NewieVentures/Obelisk/sch/FP1/FP1.kicad_pcb

## KiCad design sch/FP1/FP1.kicad_pcb (2018-10-18)

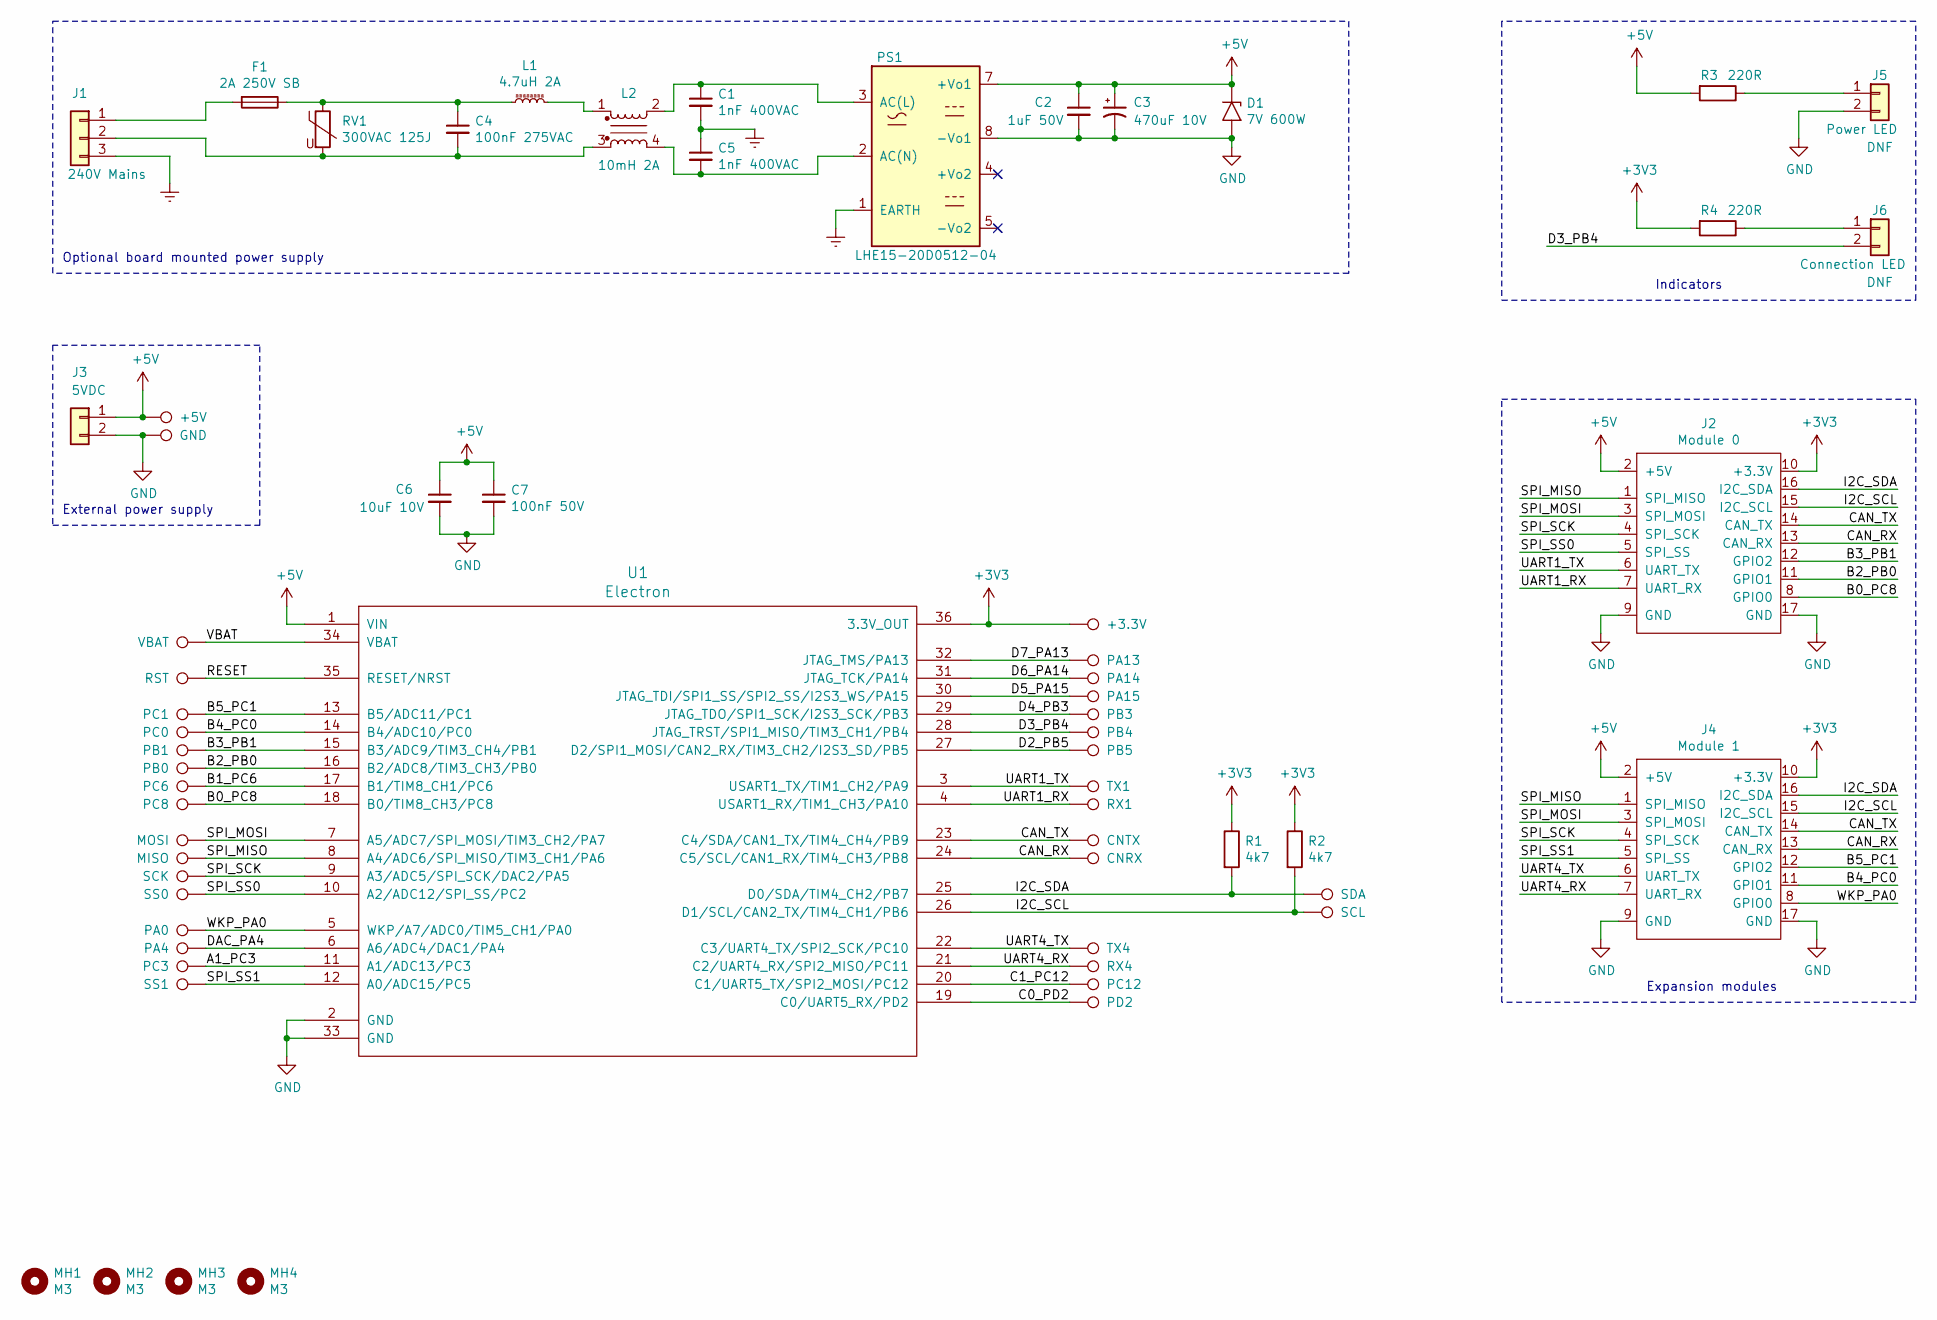
[picture p3: schematic FP1.sch, Faraday FP1]

Parts:
C1, C5: 1nF 400VAC; C_0805_2012Metric; Part Number CGA4C4C0G2W102J060AA
C2: 1uF 50V; C_0805_2012Metric; Part Number CL21B105KBFNNNG
C3: 470uF 10V; CP_Radial_D6.3mm_P2.50mm; Part Number ESH477M010AE3AA
C4: 100nF 275VAC; C_1210_3225Metric; Part Number C1210C104KBRAC7800
C6: 10uF 10V; C_0805_2012Metric; Part Number CL21A106KPCLQNC
C7: 100nF 50V; C_0805_2012Metric; Part Number GCM21BR71H104KA37K
D1: 7V 600W; D_SMB; Part Number SMBJ7.0A
F1: 2A 250V SB; Fuse_SMD_10W_3H; Part Number 3403.0169.11
J1: 240V Mains; JST_VH_B3P-VH-B_1x03_P3.96mm_Vertical; Part Number B3P-VH(LF)(SN)
J2: Module 0; Faraday_module; Part Number PPPC091LFBN-RC
J3: 5VDC; JST_VH_B2P-VH_1x02_P3.96mm_Vertical; Part Number B2P-VH(LF)(SN)
J4: Module 1; Faraday_module; Part Number PPPC091LFBN-RC
J5: Power LED; JST_VH_B2P-VH_1x02_P3.96mm_Vertical; Part Number B2P-VH(LF)(SN)
J6: Connection LED; JST_VH_B2P-VH_1x02_P3.96mm_Vertical; Part Number B2P-VH(LF)(SN)
L1: 4.7uH 2A; L_Taiyo-Yuden_NR-50xx; Part Number NRS5020T4R7MMGJ
L2: 10mH 2A; Choke_Schaffner_RN143-02-33.1x32.5mm; Part Number RN143-2-02-10M
MH1, MH2, MH3, MH4: M3; MountingHole_3.5mm
PS1: LHE15-20D0512-04; LHE15-20; Part Number LHE15-20D0512-04
R1, R2: 4k7; R_0805_2012Metric; Part Number RC0805JR-074K7L
R3, R4: 220R; R_0805_2012Metric; Part Number ESR10EZPJ221
RV1: 300VAC 125J; RV_Disc_D16.5mm_W7.5mm_P7.5mm; Part Number MOV-14D471K
TP1: VBAT; TestPoint_Loop_D2.50mm_Drill1.0mm
TP2: PA13; TestPoint_Loop_D2.50mm_Drill1.0mm
TP3: RST; TestPoint_Loop_D2.50mm_Drill1.0mm
TP4: PA14; TestPoint_Loop_D2.50mm_Drill1.0mm
TP5: PA15; TestPoint_Loop_D2.50mm_Drill1.0mm
TP6: PC1; TestPoint_Loop_D2.50mm_Drill1.0mm
TP7: PB3; TestPoint_Loop_D2.50mm_Drill1.0mm
TP8: PC0; TestPoint_Loop_D2.50mm_Drill1.0mm
TP9: PB4; TestPoint_Loop_D2.50mm_Drill1.0mm
TP10: PB1; TestPoint_Loop_D2.50mm_Drill1.0mm
TP11: PB5; TestPoint_Loop_D2.50mm_Drill1.0mm
TP12: PB0; TestPoint_Loop_D2.50mm_Drill1.0mm
TP13: PC6; TestPoint_Loop_D2.50mm_Drill1.0mm
TP14: TX1; TestPoint_Loop_D2.50mm_Drill1.0mm
TP15: PC8; TestPoint_Loop_D2.50mm_Drill1.0mm
TP16: RX1; TestPoint_Loop_D2.50mm_Drill1.0mm
TP17: MOSI; TestPoint_Loop_D2.50mm_Drill1.0mm
TP18: CNTX; TestPoint_Loop_D2.50mm_Drill1.0mm
TP19: MISO; TestPoint_Loop_D2.50mm_Drill1.0mm
TP20: CNRX; TestPoint_Loop_D2.50mm_Drill1.0mm
TP21: SCK; TestPoint_Loop_D2.50mm_Drill1.0mm
TP22: SS0; TestPoint_Loop_D2.50mm_Drill1.0mm
TP23: SDA; TestPoint_Loop_D2.50mm_Drill1.0mm
TP24: SCL; TestPoint_Loop_D2.50mm_Drill1.0mm
TP25: PA0; TestPoint_Loop_D2.50mm_Drill1.0mm
TP26: PA4; TestPoint_Loop_D2.50mm_Drill1.0mm
TP27: TX4; TestPoint_Loop_D2.50mm_Drill1.0mm
TP28: PC3; TestPoint_Loop_D2.50mm_Drill1.0mm
TP29: RX4; TestPoint_Loop_D2.50mm_Drill1.0mm
TP30: SS1; TestPoint_Loop_D2.50mm_Drill1.0mm
TP31: PC12; TestPoint_Loop_D2.50mm_Drill1.0mm
TP32: PD2; TestPoint_Loop_D2.50mm_Drill1.0mm
TP33: +5V; TestPoint_Loop_D2.50mm_Drill1.0mm
TP34: GND; Test_Point_Alligator_Clip_And_Probe
TP35: +3.3V; TestPoint_Loop_D2.50mm_Drill1.0mm
U1: Electron; PARTICLE_ELECTRON; Part Number Electron

Connections:
+3V3: J2.10 (+3.3V), J4.10 (+3.3V), R1.1, R2.1, R4.2, TP35.1, U1.36 (3.3V_OUT)
+5V: C2.1, C3.1, C6.1, C7.1, D1.1 (A1), J2.2 (+5V), J3.1, J4.2 (+5V), PS1.7 (+Vo1), R3.2, TP33.1, U1.1 (VIN)
/A1_PC3: TP28.1, U1.11 (A1/ADC13/PC3)
/B0_PC8: J2.8 (GPIO0), TP15.1, U1.18 (B0/TIM8_CH3/PC8)
/B1_PC6: TP13.1, U1.17 (B1/TIM8_CH1/PC6)
/B2_PB0: J2.11 (GPIO1), TP12.1, U1.16 (B2/ADC8/TIM3_CH3/PB0)
/B3_PB1: J2.12 (GPIO2), TP10.1, U1.15 (B3/ADC9/TIM3_CH4/PB1)
/B4_PC0: J4.11 (GPIO1), TP8.1, U1.14 (B4/ADC10/PC0)
/B5_PC1: J4.12 (GPIO2), TP6.1, U1.13 (B5/ADC11/PC1)
/C0_PD2: TP32.1, U1.19 (C0/UART5_RX/PD2)
/C1_PC12: TP31.1, U1.20 (C1/UART5_TX/SPI2_MOSI/PC12)
/CAN_RX: J2.13 (CAN_RX), J4.13 (CAN_RX), TP20.1, U1.24 (C5/SCL/CAN1_RX/TIM4_CH3/PB8)
/CAN_TX: J2.14 (CAN_TX), J4.14 (CAN_TX), TP18.1, U1.23 (C4/SDA/CAN1_TX/TIM4_CH4/PB9)
/D2_PB5: TP11.1, U1.27 (D2/SPI1_MOSI/CAN2_RX/TIM3_CH2/I2S3_SD/P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)
/D3_PB4: J6.2, TP9.1, U1.28 (JTAG_TRST/SPI1_MISO/TIM3_CH1/PB4)
/D4_PB3: TP7.1, U1.29 (JTAG_TDO/SPI1_SCK/I2S3_SCK/PB3)
/D5_PA15: TP5.1, U1.30 (JTAG_TDI/SPI1_SS/SPI2_SS/I2S3_WS/PA15)
/D6_PA14: TP4.1, U1.31 (JTAG_TCK/PA14)
/D7_PA13: TP2.1, U1.32 (JTAG_TMS/PA13)
/DAC_PA4: TP26.1, U1.6 (A6/ADC4/DAC1/PA4)
/I2C_SCL: J2.15 (I2C_SCL), J4.15 (I2C_SCL), R2.2, TP24.1, U1.26 (D1/SCL/CAN2_TX/TIM4_CH1/PB6)
/I2C_SDA: J2.16 (I2C_SDA), J4.16 (I2C_SDA), R1.2, TP23.1, U1.25 (D0/SDA/TIM4_CH2/PB7)
/RESET: TP3.1, U1.35 (RESET/NRST)
/SPI_MISO: J2.1 (SPI_MISO), J4.1 (SPI_MISO), TP19.1, U1.8 (A4/ADC6/SPI_MISO/TIM3_CH1/PA6)
/SPI_MOSI: J2.3 (SPI_MOSI), J4.3 (SPI_MOSI), TP17.1, U1.7 (A5/ADC7/SPI_MOSI/TIM3_CH2/PA7)
/SPI_SCK: J2.4 (SPI_SCK), J4.4 (SPI_SCK), TP21.1, U1.9 (A3/ADC5/SPI_SCK/DAC2/PA5)
/SPI_SS0: J2.5 (SPI_SS), TP22.1, U1.10 (A2/ADC12/SPI_SS/PC2)
/SPI_SS1: J4.5 (SPI_SS), TP30.1, U1.12 (A0/ADC15/PC5)
/UART1_RX: J2.7 (UART_RX), TP16.1, U1.4 (USART1_RX/TIM1_CH3/PA10)
/UART1_TX: J2.6 (UART_TX), TP14.1, U1.3 (USART1_TX/TIM1_CH2/PA9)
/UART4_RX: J4.7 (UART_RX), TP29.1, U1.21 (C2/UART4_RX/SPI2_MISO/PC11)
/UART4_TX: J4.6 (UART_TX), TP27.1, U1.22 (C3/UART4_TX/SPI2_SCK/PC10)
/VBAT: TP1.1, U1.34 (VBAT)
/WKP_PA0: J4.8 (GPIO0), TP25.1, U1.5 (WKP/A7/ADC0/TIM5_CH1/PA0)
Earth: C1.2, C5.1, J1.3, PS1.1 (EARTH)
GND: C2.2, C3.2, C6.2, C7.2, D1.2 (A2), J2.9 (GND), J2.17 (GND), J3.2, J4.9 (GND), J4.17 (GND), J5.2, PS1.8 (-Vo1), TP34.1, U1.2 (GND), U1.33 (GND)
unnamed: C1.1, L2.2, PS1.3 (AC(L))
unnamed: C4.1, F1.1, L1.1, RV1.1
unnamed: C4.2, J1.2, L2.3, RV1.2
unnamed: C5.2, L2.4, PS1.2 (AC(N))
unnamed: F1.2, J1.1
unnamed: J5.1, R3.1
unnamed: J6.1, R4.1
unnamed: L1.2, L2.1

Notes on the sheet:
Optional board mounted power supply
Expansion modules
External power supply
Indicators

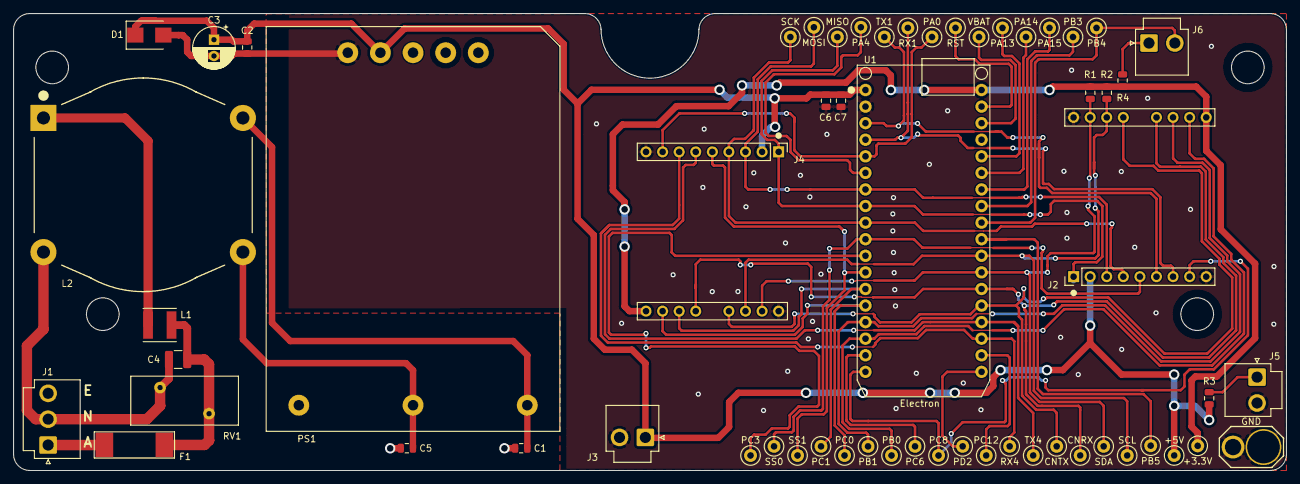
[picture p4: board FP1.kicad_pcb from above]

Board: 2 copper layers, 195.0 x 70.0 mm, 63 parts (0 on the bottom side), 44 nets.
